paudrow/alarm-clock-m5cores3/hardware/cad/viewer_template.html

# Alarm clock enclosure.

From the V2 breadboard, with 3D-printed holders, to the V3 black-anodized aluminium clock on a ½″ low-iron glass base that glows 660 nm red. Drag to orbit, scroll or pinch to zoom, hover a part to name it, and press Explode to take it apart.

Loading model…

¾ view Front Back Side Below

Interact Explode

Tap, hold and drag on the clock's screen. It's running the real firmware. Press Done or Esc to leave.

## Version

V2 breadboard V3 · 4.1″ V3 · 2.41″

Explode

Lamp on See inside Screen on Colour parts

## The clock, running

Time

–

Screen

–

Alarm

–

Lamp

–

Sleep sound

–

Resolution

–

Jump to

Daytime Wind down Night Wake up Alarm

Clock speed

Real time 60× 600×

Set the clock to Set

Press the button Sleep sound on/off

Serial Send

Hear it Reset its settings

This is the clock's real firmware, src/main.cpp, compiled to WebAssembly. It draws here and on the model's screen, drives the lamp in the glass and plays the sleep sounds. On the model, click the screen to use it, the glass to switch the lamp, the speaker for sleep sounds and the top button to snooze. Jump to moves the clock's time. Wind down and Wake up turn those lamp schedules on and jump to their start; Alarm turns the alarm on and sets the clock 10 seconds before it. The Serial box takes the same commands as the real clock's USB console; so does clock.command() in the browser console. Settings are kept in this browser, the way the clock keeps them through a power cut.

## Fit check

## Cost per clock, batch of 10

Item | $ each

Your hours per clock

Your rate, $/h

Selling price

Cash

With your time

Margin each

Edit any price to try a real quote; your edits stay in this browser. Margin allows 3% for card fees and assumes shipping is charged to the buyer. Certification (FCC testing, $1,000–3,000 for the batch) is not included.

## Where to buy

Links open the store's product page. Prices are from search results and were not checked in a cart; confirm before ordering.

## Parts

Generated from hardware/cad/clock.py (CadQuery). STEP and STL files for every part are in hardware/cad/out/, ready for the 3D printer or CAM. The 4.1″ screen module uses the outline measured from LilyGO's published T-Display-P4 model; the 2.41″ outline is an estimate until the Waveshare drawing is checked. The screen, lamp and speaker are driven by the clock's real firmware (src/main.cpp), running in the page.
