paudrow/alarm-clock-m5cores3/hardware/cad/out/bench/assembly.step

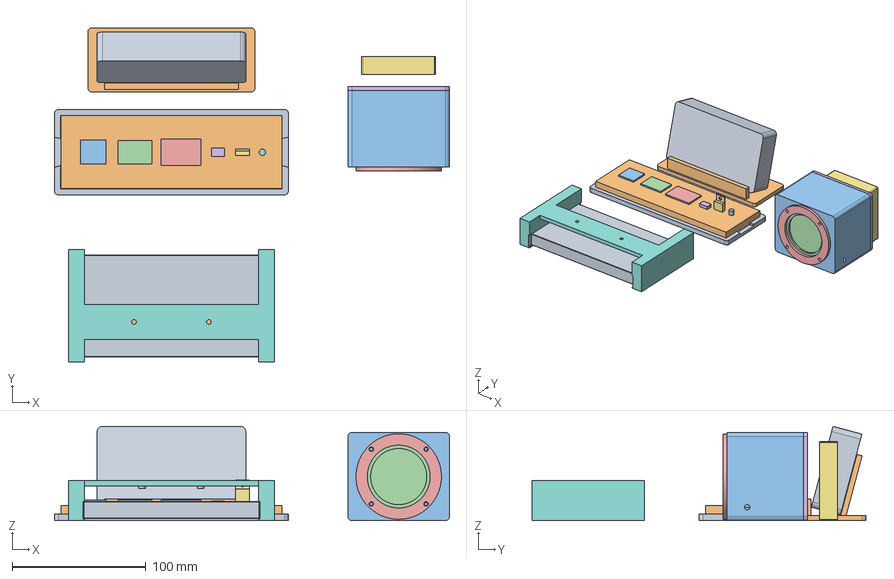
[picture p2: CAD file, 2026-09-29]
hardware/cad/out/bench/assembly.step
295.5 x 250.1 x 70.6 mm
bb_tray
breadboard
amp
light_sensor
rtc
opamp
mosfet
mosfet_small
tdisplay
display_stand
spk_box
speaker
spk_ring
spk_lid
spk_filler
lamp_cradle
glass_sample
led_stars
