paudrow/alarm-clock-m5cores3/hardware/cad/out/lean/assembly.step

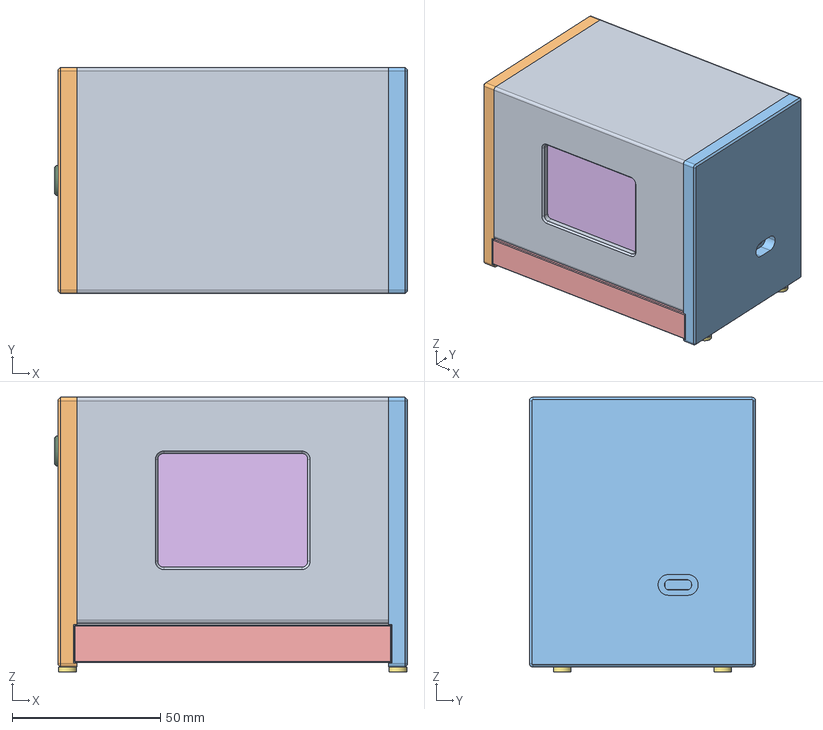
[picture p3: CAD file, 2026-09-29]
hardware/cad/out/lean/assembly.step
118.9 x 76.2 x 92.5 mm
tube
cap_left
cap_right
button
glass_base
screen
screen_frame
sled
pcb
standoffs
usb_c
leds
chamber
speaker
feet
