paudrow/alarm-clock-m5cores3/hardware/cad/out/bench/display_stand.step

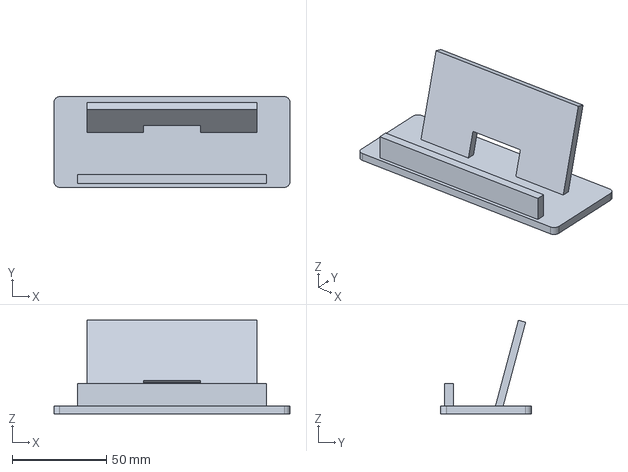
[picture p4: CAD file, 2026-09-29]
hardware/cad/out/bench/display_stand.step
125.0 x 48.0 x 49.5 mm
