paudrow/alarm-clock-m5cores3/hardware/cad/out/lean/screen.step

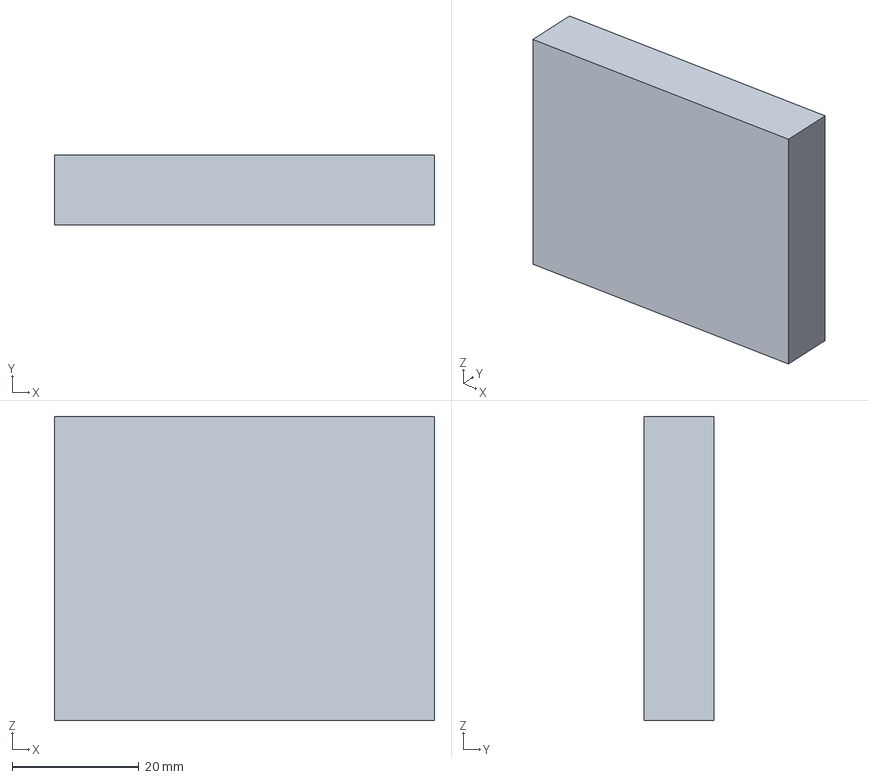
[picture p5: CAD file, 2026-09-29]
hardware/cad/out/lean/screen.step
60.0 x 11.0 x 48.0 mm
