paudrow/alarm-clock-m5cores3/hardware/cad/out/full/screen_frame.step

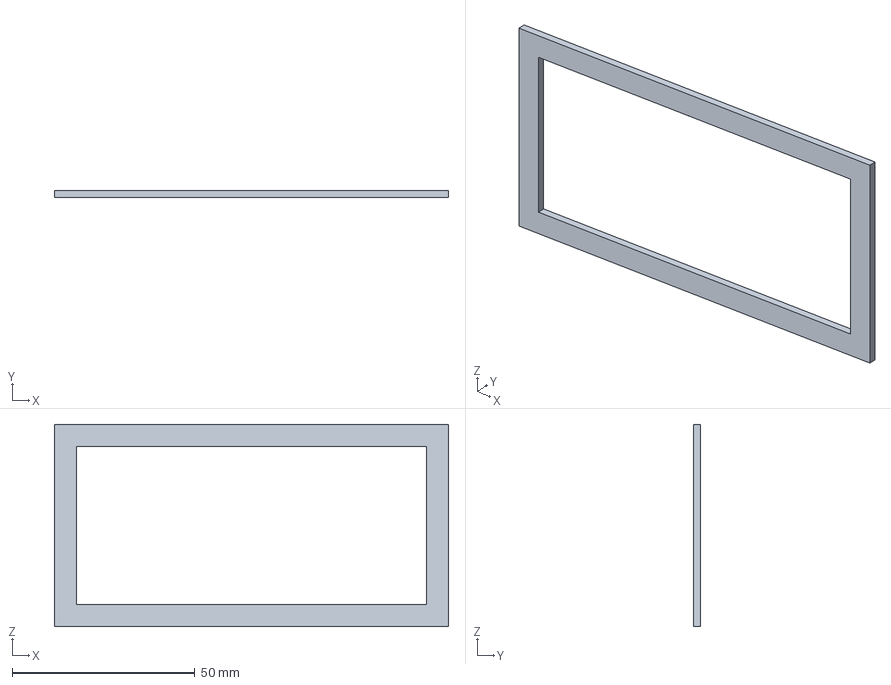
[picture p6: CAD file, 2026-09-29]
hardware/cad/out/full/screen_frame.step
107.8 x 2.00 x 55.3 mm
