paudrow/alarm-clock-m5cores3/hardware/cad/out/lean/feet.step

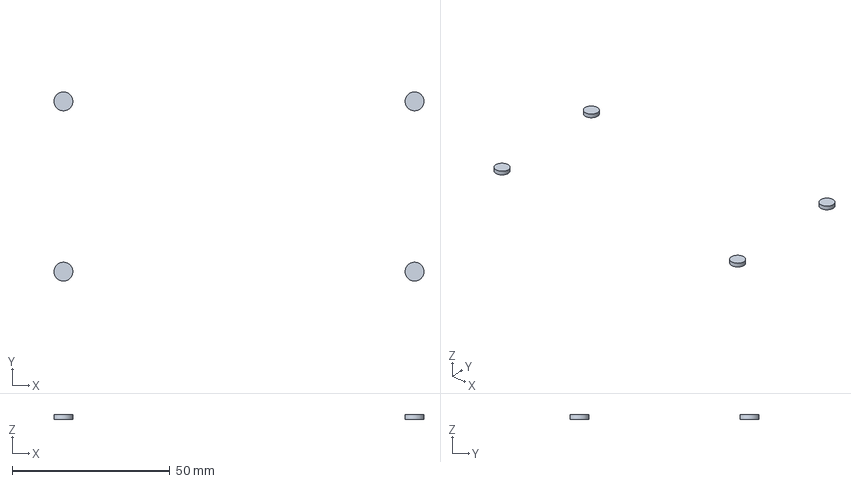
[picture p7: CAD file, 2026-09-29]
hardware/cad/out/lean/feet.step
117.3 x 60.0 x 1.60 mm
