paudrow/alarm-clock-m5cores3/hardware/cad/out/bench/bb_tray.step

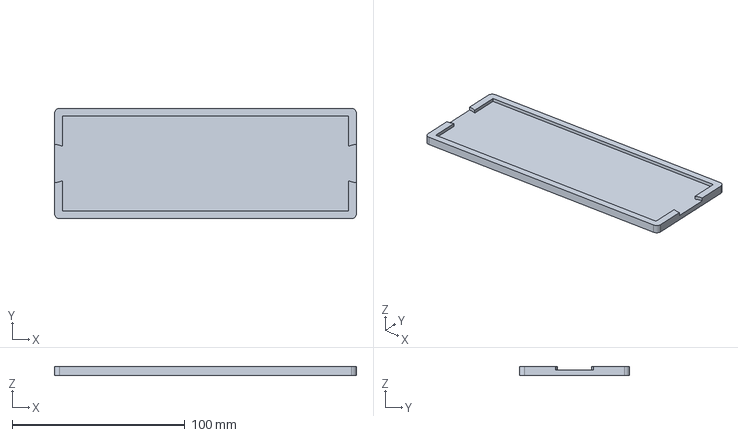
[picture p8: CAD file, 2026-09-29]
hardware/cad/out/bench/bb_tray.step
175.0 x 64.0 x 5.00 mm
