paudrow/alarm-clock-m5cores3/hardware/cad/out/full/screen.step

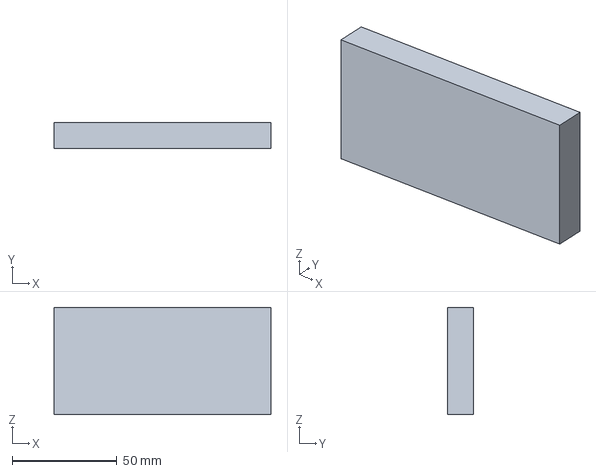
[picture p9: CAD file, 2026-09-29]
hardware/cad/out/full/screen.step
103.8 x 12.3 x 51.3 mm
