paudrow/alarm-clock-m5cores3/hardware/cad/out/lean/standoffs.step

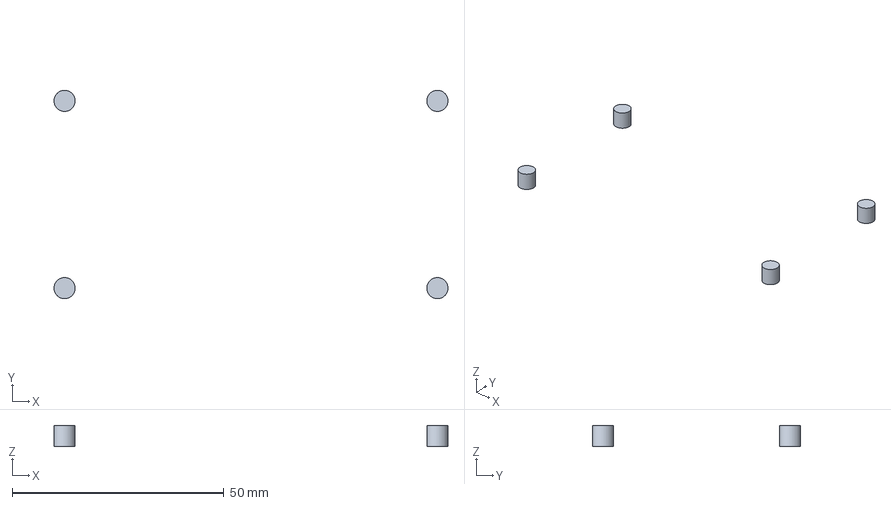
[picture p10: CAD file, 2026-09-29]
hardware/cad/out/lean/standoffs.step
93.0 x 49.2 x 5.00 mm
