paudrow/alarm-clock-m5cores3/hardware/cad/out/bench/glass_sample.step

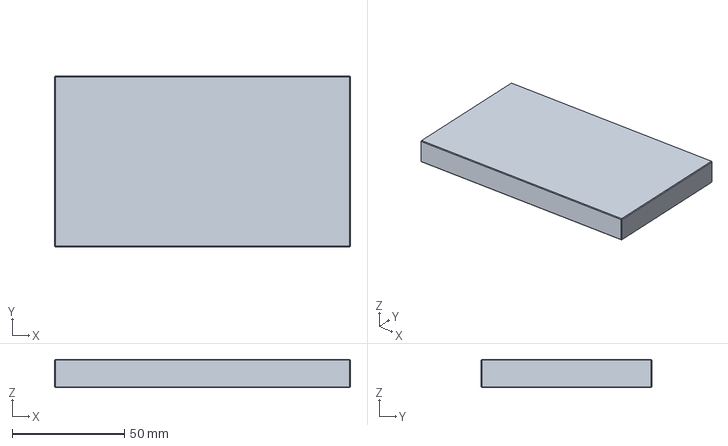
[picture p11: CAD file, 2026-09-29]
hardware/cad/out/bench/glass_sample.step
132.0 x 76.2 x 12.7 mm
