paudrow/alarm-clock-m5cores3/hardware/cad/out/full/tube.step

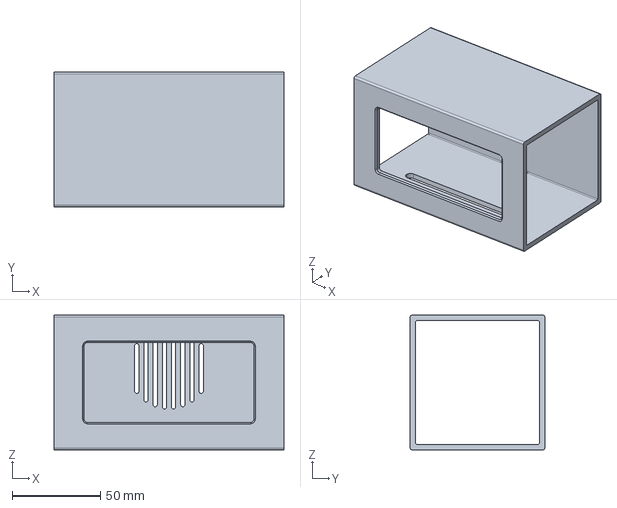
[picture p12: CAD file, 2026-09-29]
hardware/cad/out/full/tube.step
130.0 x 76.2 x 76.2 mm
