paudrow/alarm-clock-m5cores3/hardware/cad/out/bench/amp.step

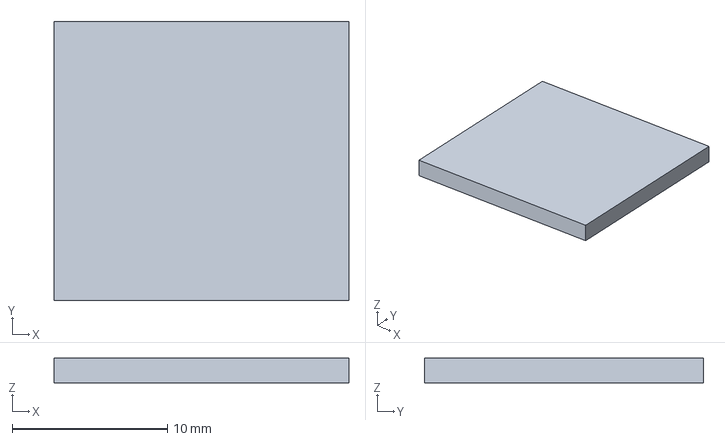
[picture p14: CAD file, 2026-09-29]
hardware/cad/out/bench/amp.step
19.0 x 18.0 x 1.60 mm
