paudrow/alarm-clock-m5cores3/hardware/cad/out/full/speaker.step

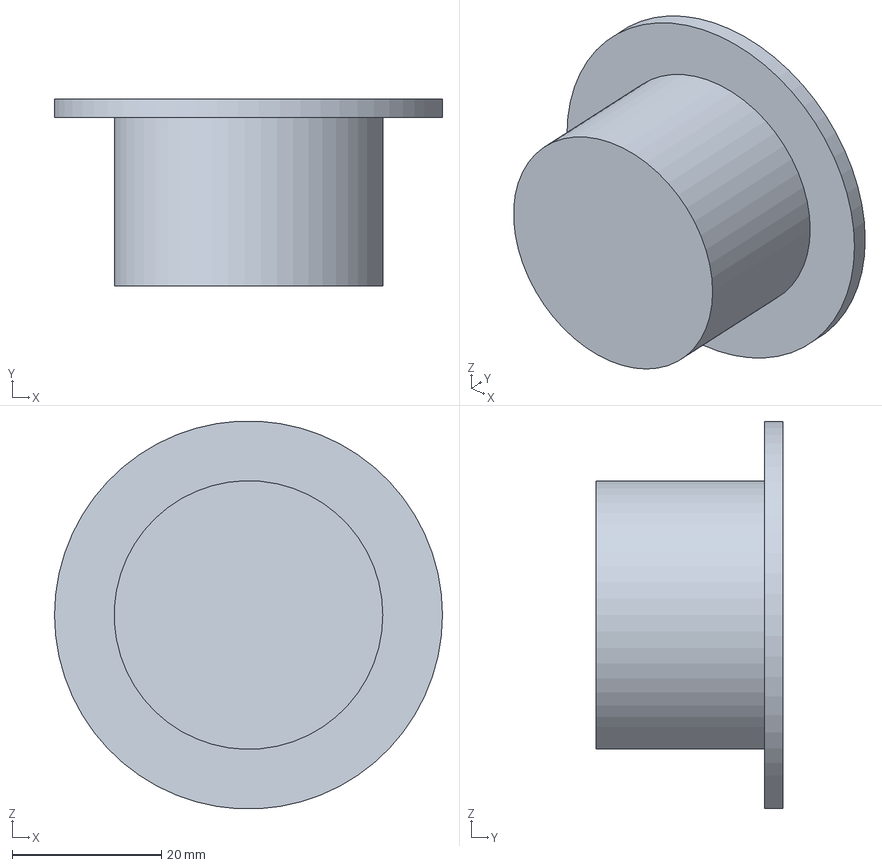
[picture p15: CAD file, 2026-09-29]
hardware/cad/out/full/speaker.step
52.0 x 25.1 x 51.9 mm
