paudrow/alarm-clock-m5cores3/hardware/cad/out/lean/sled.step

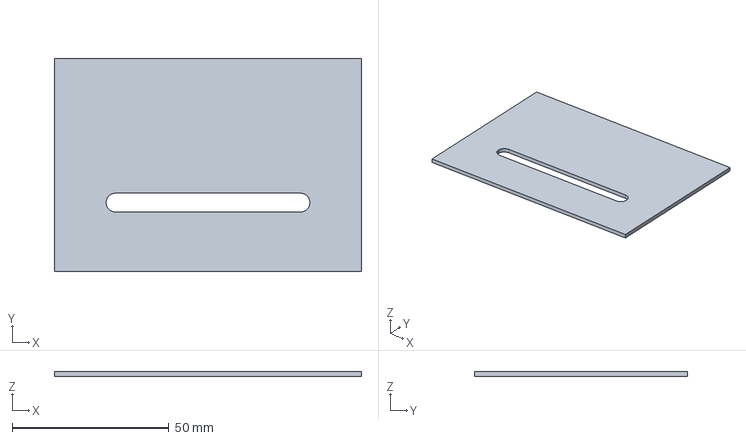
[picture p16: CAD file, 2026-09-29]
hardware/cad/out/lean/sled.step
98.0 x 67.8 x 1.60 mm
