paudrow/alarm-clock-m5cores3/hardware/cad/out/bench/mosfet.step

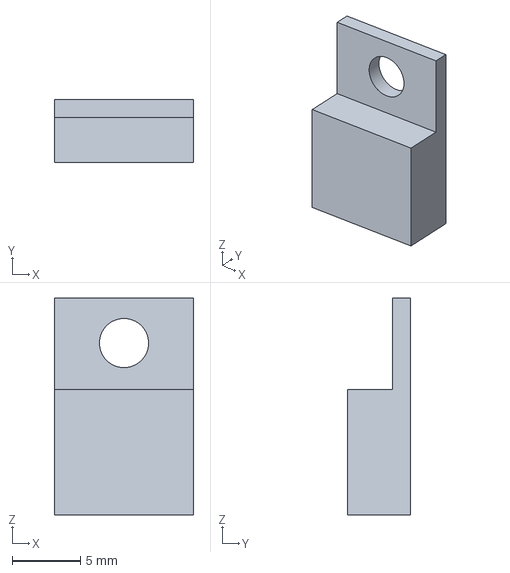
[picture p17: CAD file, 2026-09-29]
hardware/cad/out/bench/mosfet.step
10.2 x 4.60 x 15.9 mm
