paudrow/alarm-clock-m5cores3/hardware/cad/out/full/chamber.step

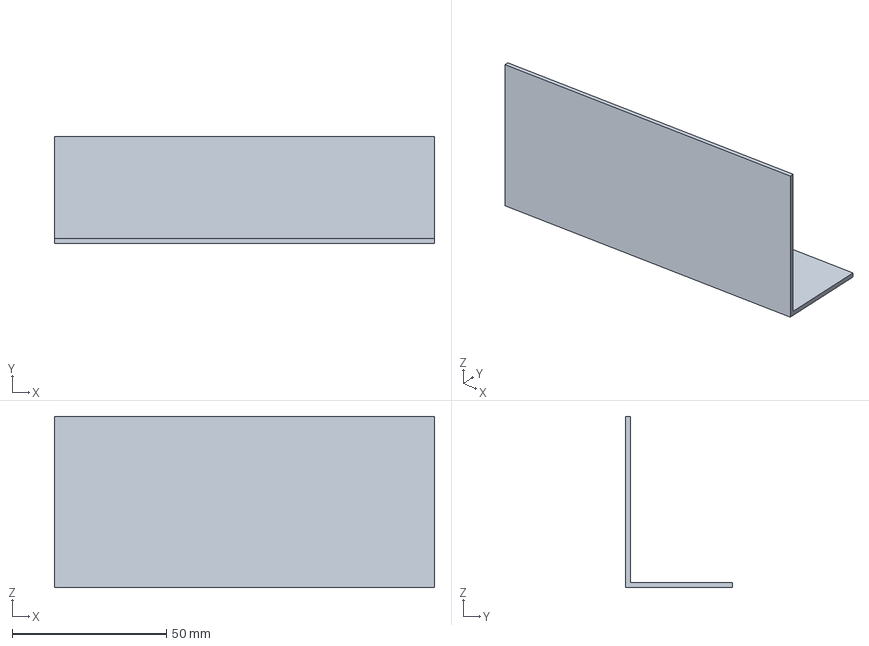
[picture p18: CAD file, 2026-09-29]
hardware/cad/out/full/chamber.step
123.0 x 34.6 x 55.3 mm
