paudrow/alarm-clock-m5cores3/hardware/cad/out/lean/glass_base.step

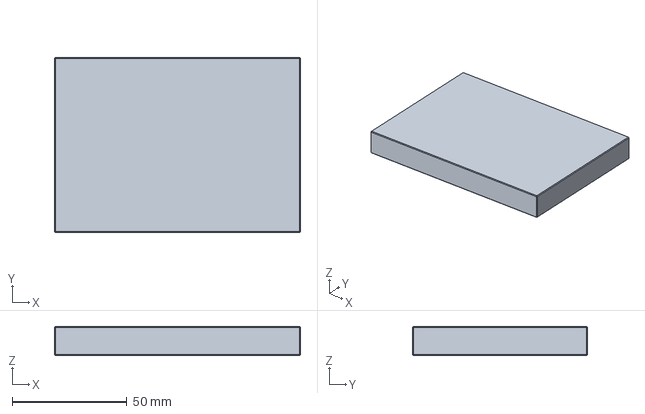
[picture p19: CAD file, 2026-09-29]
hardware/cad/out/lean/glass_base.step
107.0 x 76.2 x 12.7 mm
