paudrow/alarm-clock-m5cores3/hardware/cad/out/bench/speaker.step

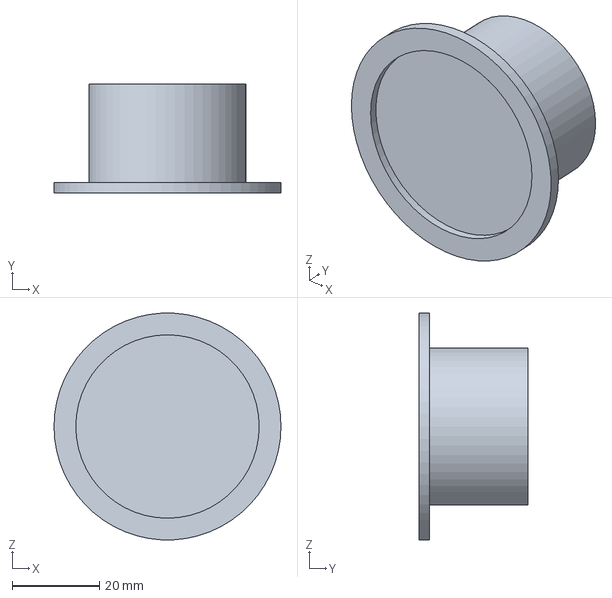
[picture p20: CAD file, 2026-09-29]
hardware/cad/out/bench/speaker.step
52.0 x 25.0 x 51.9 mm
