paudrow/alarm-clock-m5cores3/hardware/cad/out/full/pcb.step

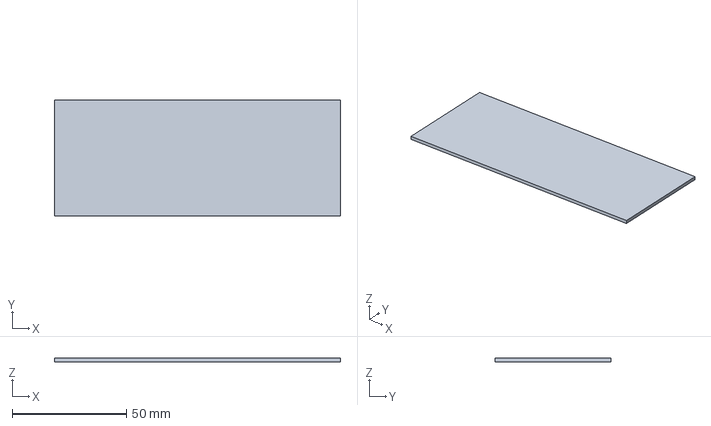
[picture p21: CAD file, 2026-09-29]
hardware/cad/out/full/pcb.step
125.0 x 50.9 x 1.60 mm
