paudrow/alarm-clock-m5cores3/hardware/cad/out/bench/mosfet_small.step

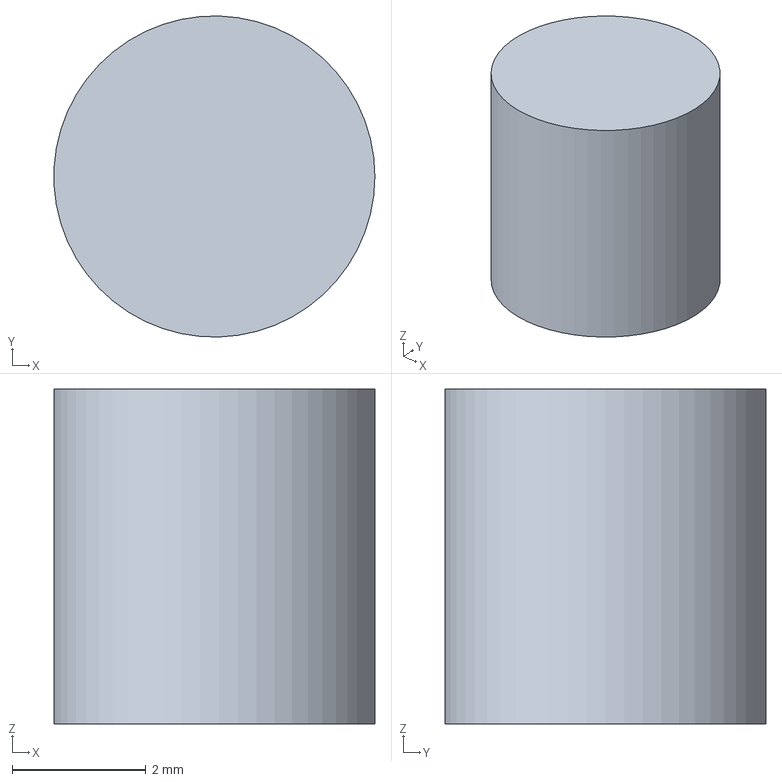
[picture p22: CAD file, 2026-09-29]
hardware/cad/out/bench/mosfet_small.step
4.80 x 4.80 x 5.00 mm
