paudrow/alarm-clock-m5cores3/hardware/cad/out/full/sled.step

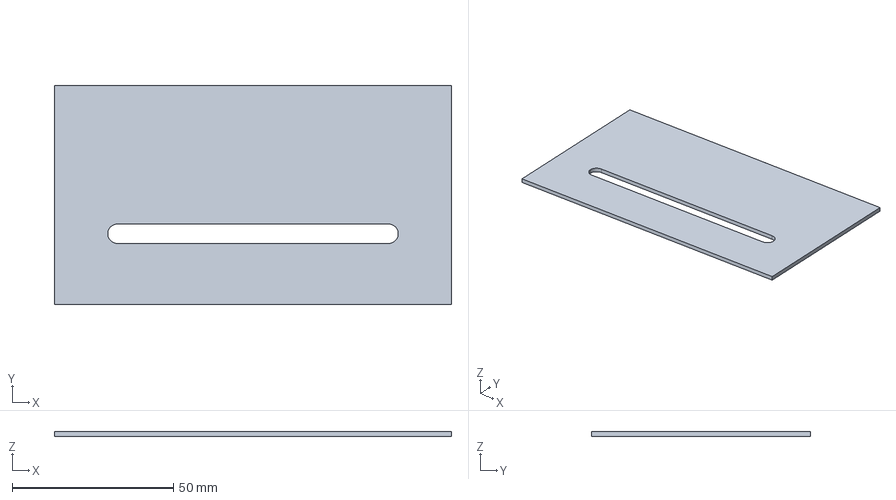
[picture p23: CAD file, 2026-09-29]
hardware/cad/out/full/sled.step
123.0 x 67.8 x 1.60 mm
