paudrow/alarm-clock-m5cores3/hardware/cad/out/lean/button.step

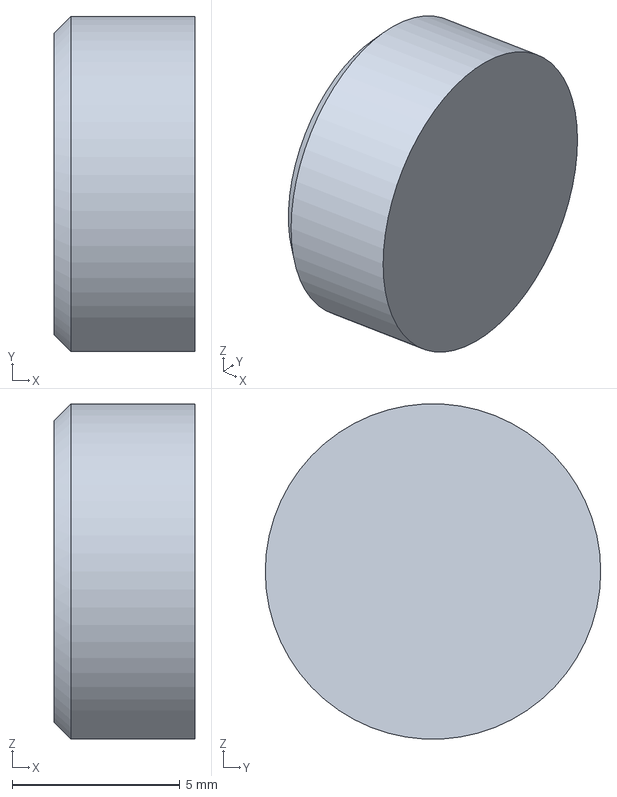
[picture p24: CAD file, 2026-09-29]
hardware/cad/out/lean/button.step
4.20 x 10.0 x 9.99 mm
