paudrow/alarm-clock-m5cores3/hardware/cad/out/bench/breadboard.step

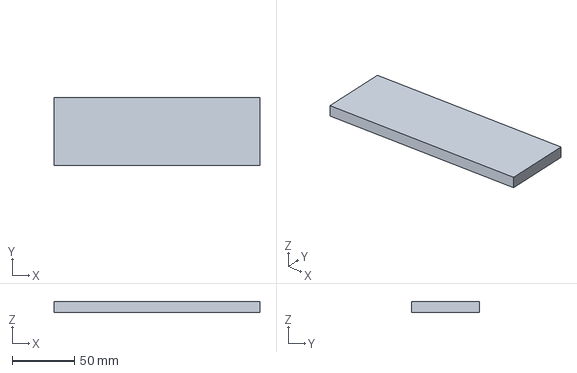
[picture p25: CAD file, 2026-09-29]
hardware/cad/out/bench/breadboard.step
165.1 x 54.6 x 8.50 mm
