paudrow/alarm-clock-m5cores3/hardware/cad/out/full/cap_right.step

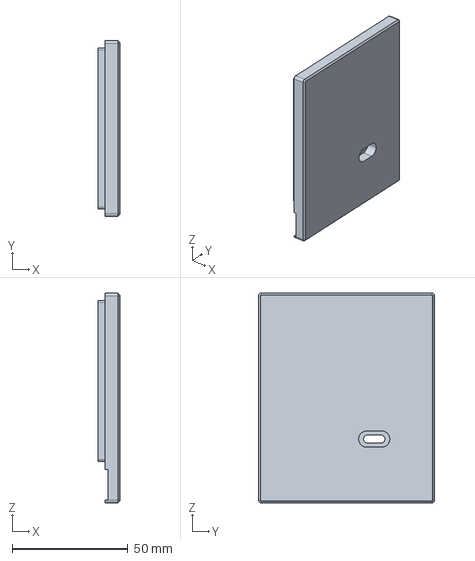
[picture p26: CAD file, 2026-09-29]
hardware/cad/out/full/cap_right.step
9.35 x 76.2 x 90.9 mm
