paudrow/alarm-clock-m5cores3/hardware/cad/out/lean/tube.step

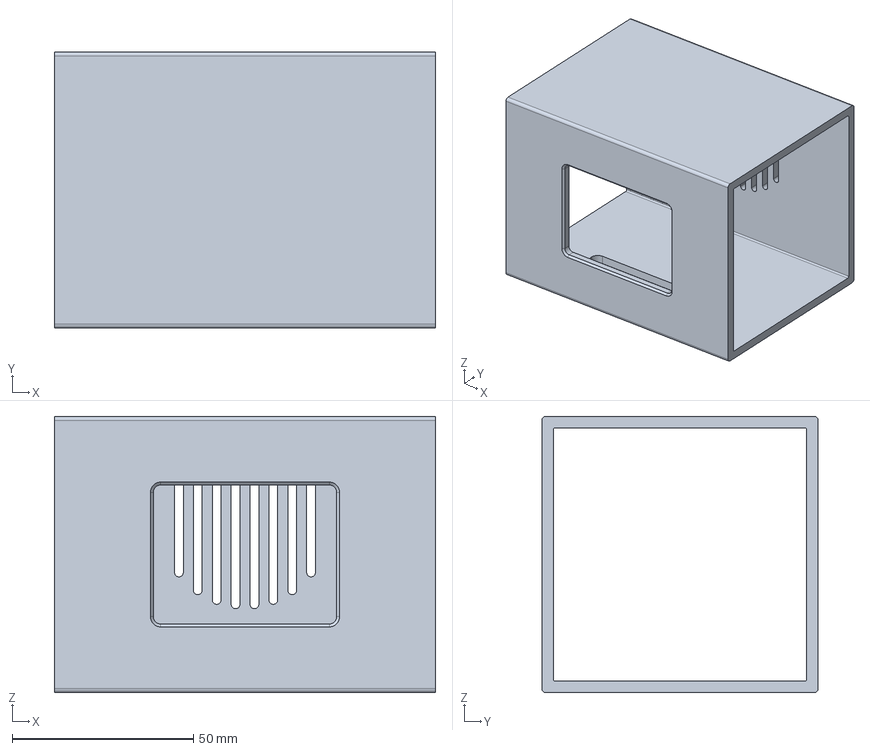
[picture p27: CAD file, 2026-09-29]
hardware/cad/out/lean/tube.step
105.0 x 76.2 x 76.2 mm
