paudrow/alarm-clock-m5cores3/hardware/cad/out/bench/lamp_cradle.step

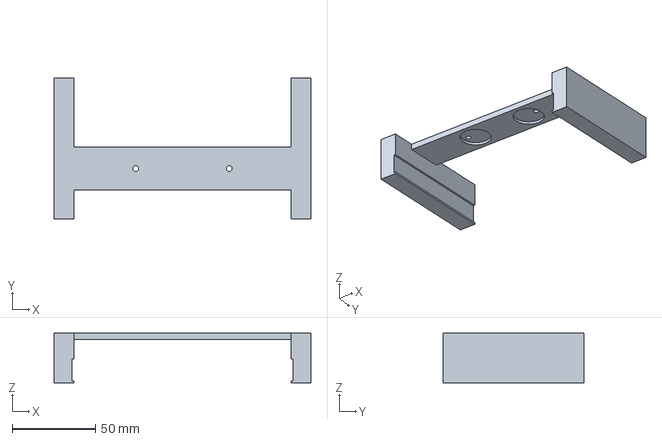
[picture p28: CAD file, 2026-09-29]
hardware/cad/out/bench/lamp_cradle.step
154.0 x 84.2 x 29.9 mm
