paudrow/alarm-clock-m5cores3/hardware/cad/out/full/standoffs.step

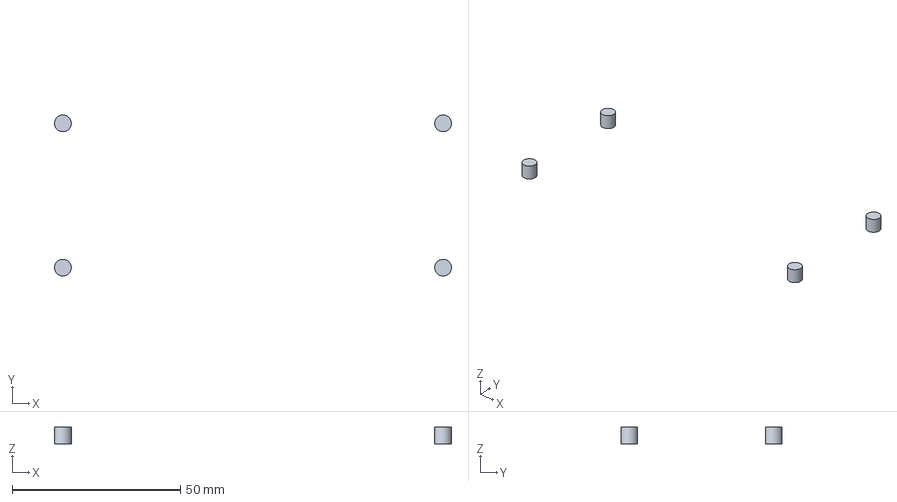
[picture p29: CAD file, 2026-09-29]
hardware/cad/out/full/standoffs.step
118.0 x 47.9 x 5.00 mm
