paudrow/alarm-clock-m5cores3/hardware/cad/out/lean/pcb.step

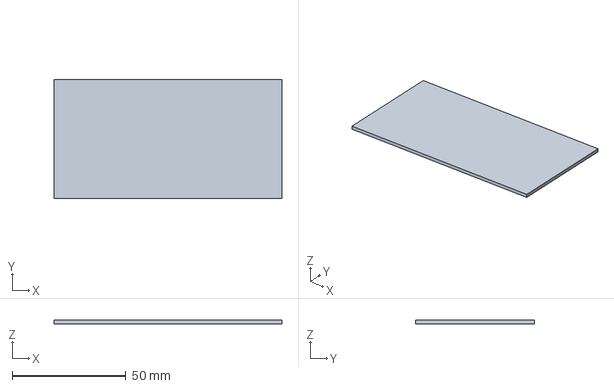
[picture p30: CAD file, 2026-09-29]
hardware/cad/out/lean/pcb.step
100.0 x 52.2 x 1.60 mm
