paudrow/alarm-clock-m5cores3/hardware/cad/out/bench/light_sensor.step

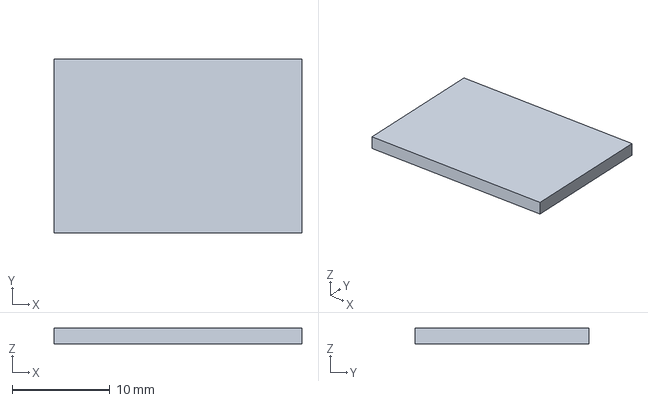
[picture p31: CAD file, 2026-09-29]
hardware/cad/out/bench/light_sensor.step
25.4 x 17.8 x 1.60 mm
