paudrow/alarm-clock-m5cores3/hardware/cad/out/lean/usb_c.step

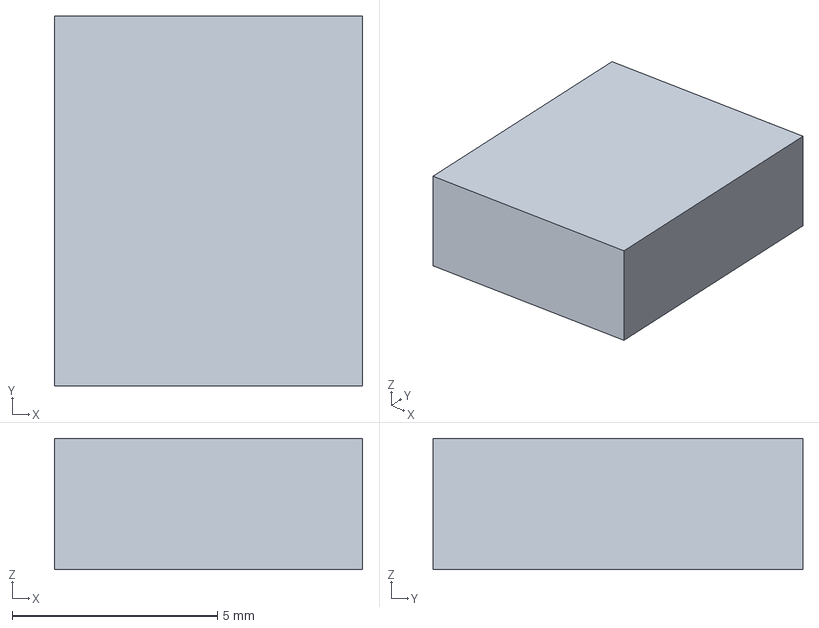
[picture p32: CAD file, 2026-09-29]
hardware/cad/out/lean/usb_c.step
7.50 x 9.00 x 3.20 mm
