paudrow/alarm-clock-m5cores3/hardware/cad/out/bench/rtc.step

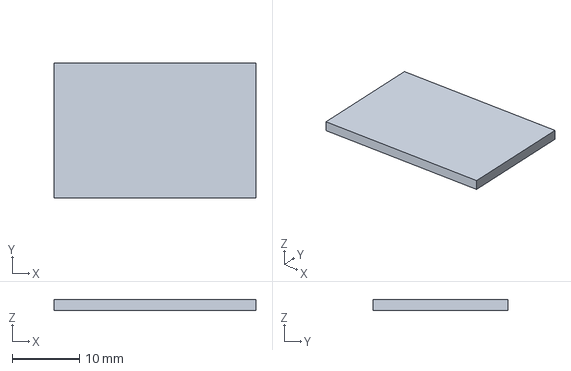
[picture p33: CAD file, 2026-09-29]
hardware/cad/out/bench/rtc.step
30.0 x 20.0 x 1.60 mm
