paudrow/alarm-clock-m5cores3/hardware/cad/out/lean/chamber.step

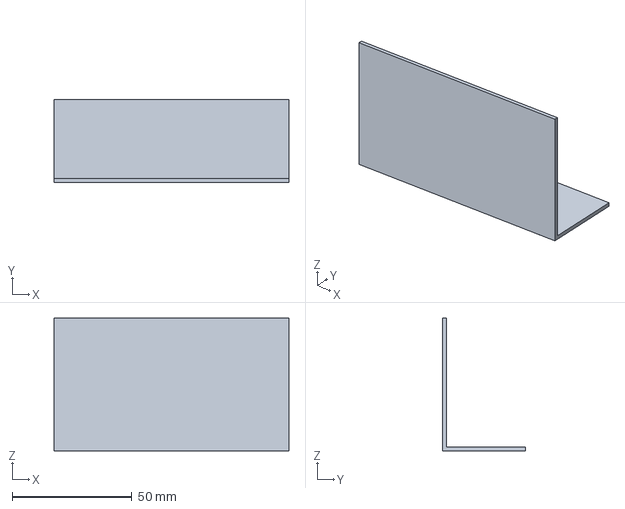
[picture p34: CAD file, 2026-09-29]
hardware/cad/out/lean/chamber.step
98.0 x 34.6 x 55.3 mm
