paudrow/alarm-clock-m5cores3/hardware/cad/out/bench/led_stars.step

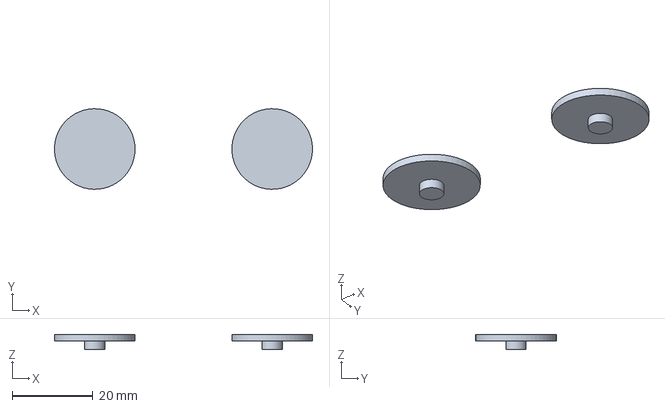
[picture p35: CAD file, 2026-09-29]
hardware/cad/out/bench/led_stars.step
64.0 x 20.0 x 3.60 mm
