paudrow/alarm-clock-m5cores3/hardware/cad/out/lean/leds.step

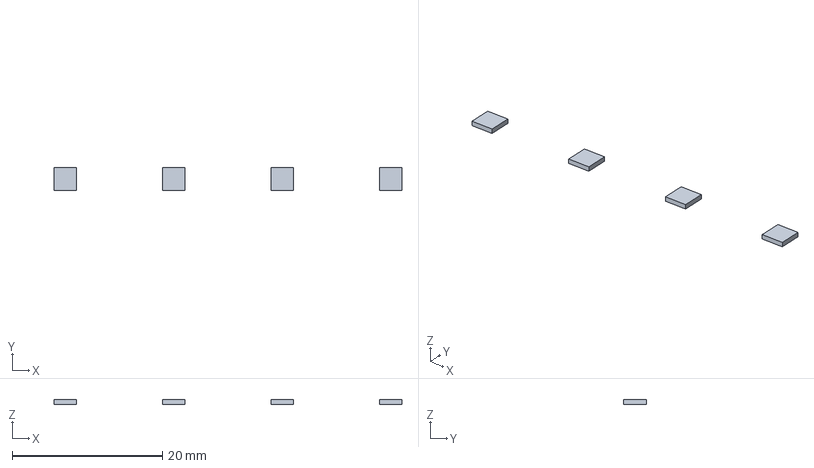
[picture p36: CAD file, 2026-09-29]
hardware/cad/out/lean/leds.step
46.3 x 3.00 x 0.6 mm
