paudrow/alarm-clock-m5cores3/hardware/cad/out/bench/spk_ring.step

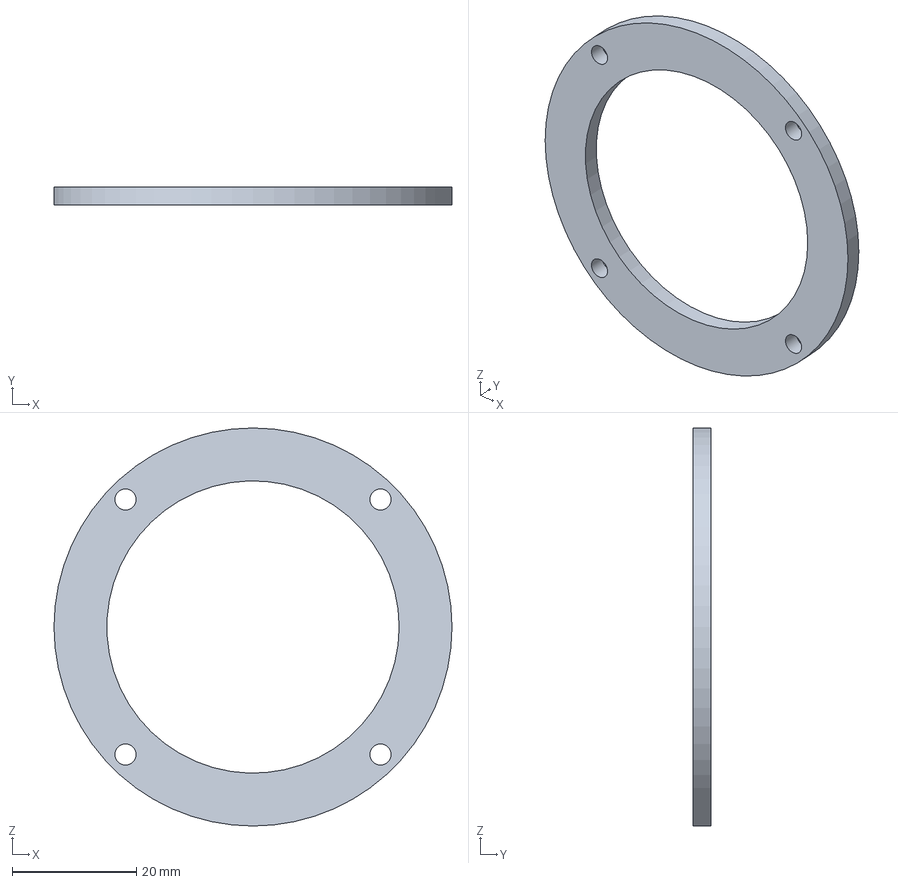
[picture p37: CAD file, 2026-09-29]
hardware/cad/out/bench/spk_ring.step
64.0 x 2.95 x 64.0 mm
