paudrow/alarm-clock-m5cores3/hardware/cad/out/bench/spk_box.step

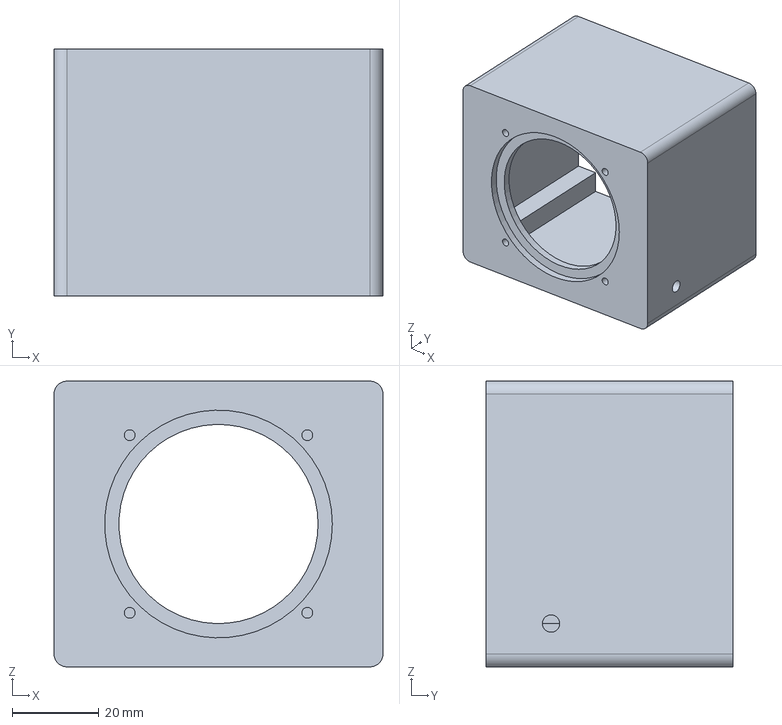
[picture p38: CAD file, 2026-09-29]
hardware/cad/out/bench/spk_box.step
76.0 x 57.0 x 66.0 mm
