paudrow/alarm-clock-m5cores3/hardware/cad/out/full/leds.step

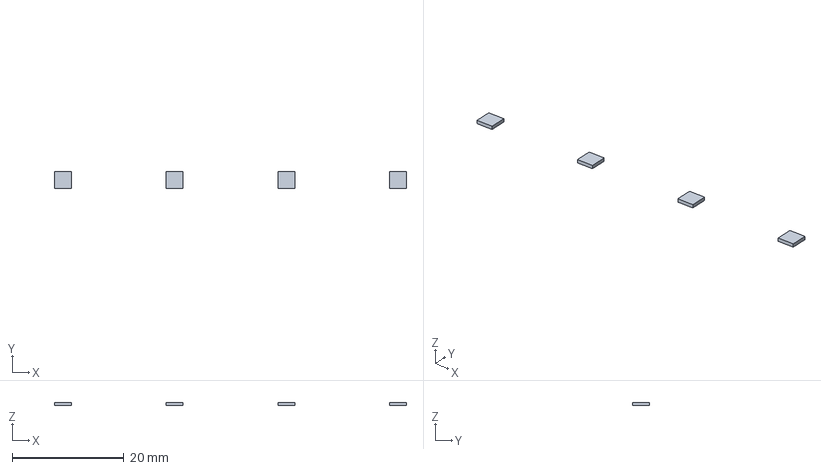
[picture p39: CAD file, 2026-09-29]
hardware/cad/out/full/leds.step
63.0 x 3.00 x 0.6 mm
