paudrow/alarm-clock-m5cores3/hardware/cad/out/bench/spk_lid.step

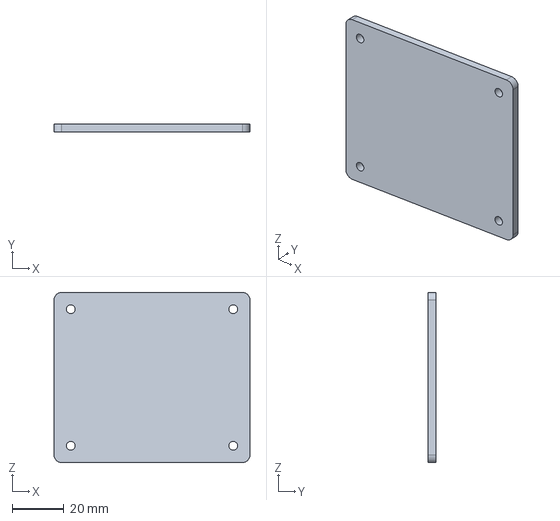
[picture p40: CAD file, 2026-09-29]
hardware/cad/out/bench/spk_lid.step
76.0 x 3.00 x 66.0 mm
