paudrow/alarm-clock-m5cores3/hardware/cad/out/full/feet.step

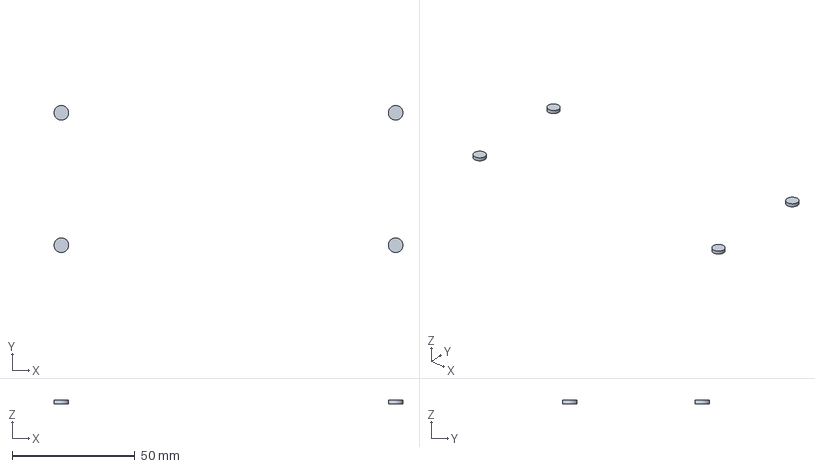
[picture p41: CAD file, 2026-09-29]
hardware/cad/out/full/feet.step
142.3 x 60.0 x 1.60 mm
