paudrow/alarm-clock-m5cores3/hardware/cad/out/lean/screen_frame.step

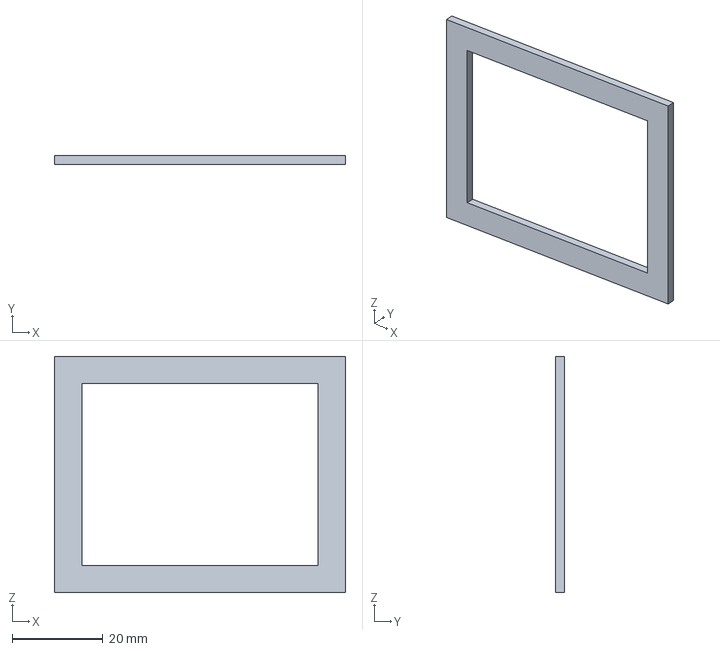
[picture p42: CAD file, 2026-09-29]
hardware/cad/out/lean/screen_frame.step
64.0 x 2.00 x 52.0 mm
