paudrow/alarm-clock-m5cores3/hardware/cad/out/bench/tdisplay.step

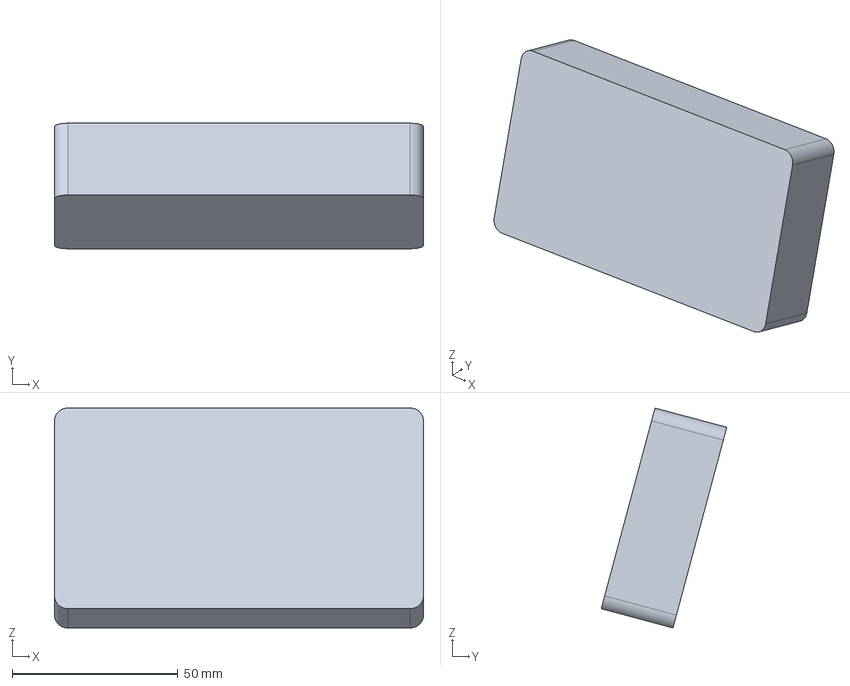
[picture p43: CAD file, 2026-09-29]
hardware/cad/out/bench/tdisplay.step
111.2 x 37.8 x 66.3 mm
