paudrow/alarm-clock-m5cores3/hardware/cad/out/bench/opamp.step

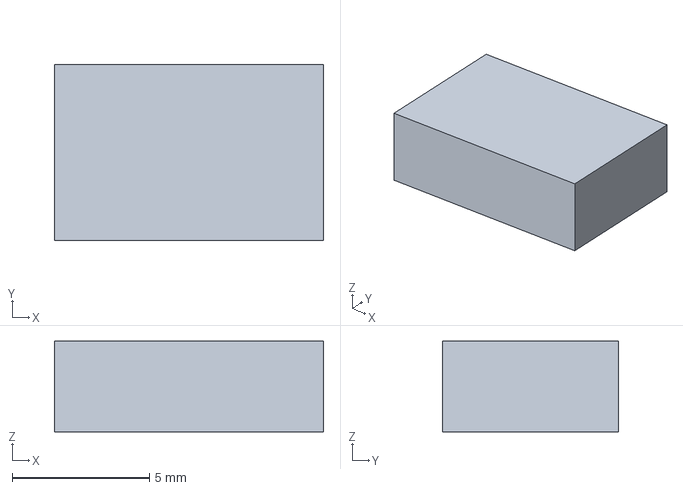
[picture p44: CAD file, 2026-09-29]
hardware/cad/out/bench/opamp.step
9.80 x 6.40 x 3.30 mm
