paudrow/alarm-clock-m5cores3/hardware/cad/out/bench/spk_filler.step

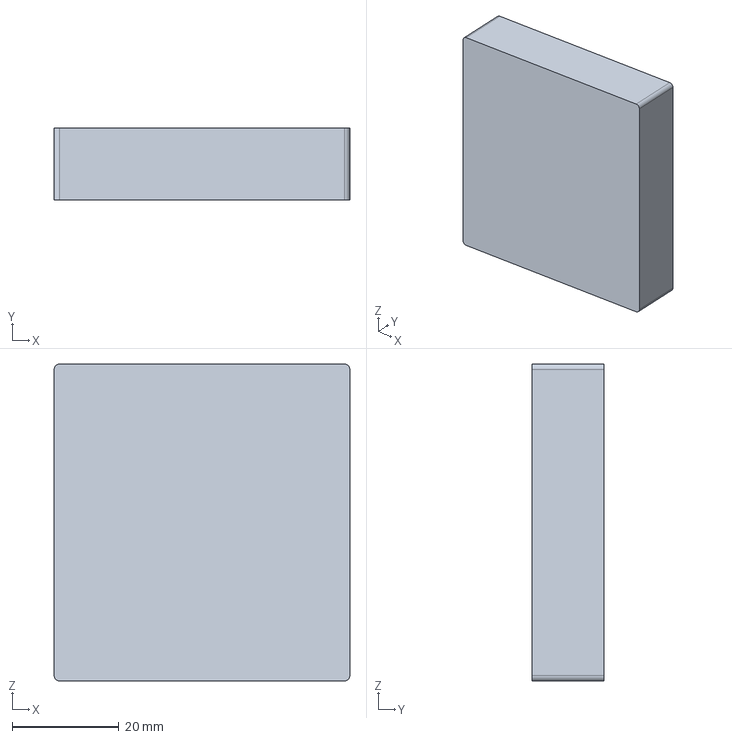
[picture p45: CAD file, 2026-09-29]
hardware/cad/out/bench/spk_filler.step
55.4 x 13.5 x 59.4 mm
