paudrow/alarm-clock-m5cores3/(list of files, cad)

Other CAD files:
hardware/cad/out/lean/cap_left.step
hardware/cad/out/full/cap_left.step
hardware/cad/out/full/button.step
hardware/cad/out/full/glass_base.step
hardware/cad/out/full/usb_c.step
hardware/cad/out/lean/speaker.step
hardware/cad/out/bench/amp.stl
hardware/cad/out/bench/bb_tray.stl
hardware/cad/out/bench/breadboard.stl
hardware/cad/out/bench/display_stand.stl
hardware/cad/out/bench/glass_sample.stl
hardware/cad/out/bench/lamp_cradle.stl
hardware/cad/out/bench/led_stars.stl
hardware/cad/out/bench/light_sensor.stl
hardware/cad/out/bench/mosfet.stl
hardware/cad/out/bench/mosfet_small.stl
hardware/cad/out/bench/opamp.stl
hardware/cad/out/bench/rtc.stl
hardware/cad/out/bench/speaker.stl
hardware/cad/out/bench/spk_box.stl
hardware/cad/out/bench/spk_filler.stl
hardware/cad/out/bench/spk_lid.stl
hardware/cad/out/bench/spk_ring.stl
hardware/cad/out/bench/tdisplay.stl
hardware/cad/out/full/button.stl
hardware/cad/out/full/cap_left.stl
hardware/cad/out/full/cap_right.stl
hardware/cad/out/full/chamber.stl
hardware/cad/out/full/feet.stl
hardware/cad/out/full/glass_base.stl
hardware/cad/out/full/leds.stl
hardware/cad/out/full/pcb.stl
hardware/cad/out/full/screen.stl
hardware/cad/out/full/screen_frame.stl
hardware/cad/out/full/sled.stl
hardware/cad/out/full/speaker.stl
hardware/cad/out/full/standoffs.stl
hardware/cad/out/full/tube.stl
hardware/cad/out/full/usb_c.stl
hardware/cad/out/lean/button.stl
hardware/cad/out/lean/cap_left.stl
hardware/cad/out/lean/cap_right.stl
hardware/cad/out/lean/chamber.stl
hardware/cad/out/lean/feet.stl
hardware/cad/out/lean/glass_base.stl
hardware/cad/out/lean/leds.stl
hardware/cad/out/lean/pcb.stl
hardware/cad/out/lean/screen.stl
hardware/cad/out/lean/screen_frame.stl
hardware/cad/out/lean/sled.stl
hardware/cad/out/lean/speaker.stl
hardware/cad/out/lean/standoffs.stl
hardware/cad/out/lean/tube.stl
hardware/cad/out/lean/usb_c.stl
