paudrow/alarm-clock-m5cores3/test/screens/320x240-alarm.png

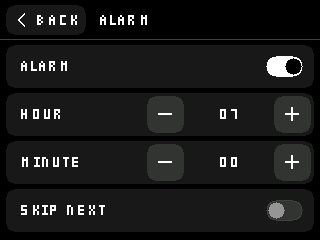
test/screens/320x240-alarm.png
