paudrow/alarm-clock-m5cores3/test/screens/320x240-alarm_sound.png

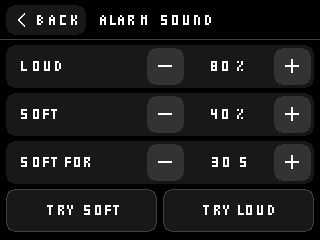
test/screens/320x240-alarm_sound.png
