paudrow/alarm-clock-m5cores3/test/screens/320x240-clock-day.png

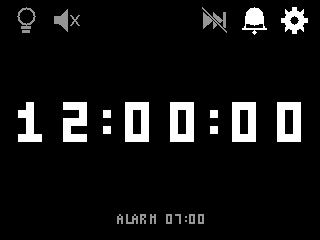
test/screens/320x240-clock-day.png
