paudrow/alarm-clock-m5cores3/test/screens/320x240-clock-night.png

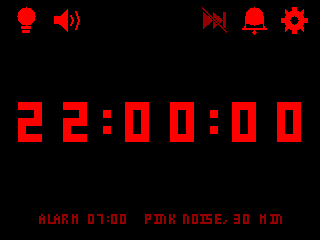
test/screens/320x240-clock-night.png
