paudrow/alarm-clock-m5cores3/test/screens/320x240-day_screen.png

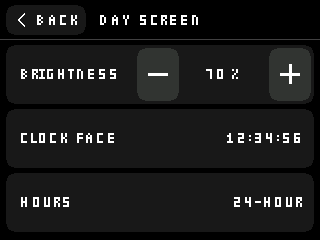
test/screens/320x240-day_screen.png
