paudrow/alarm-clock-m5cores3/test/screens/320x240-night_hours.png

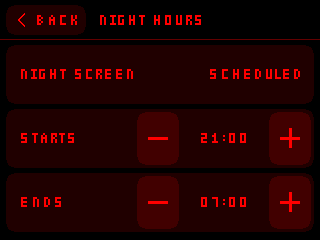
test/screens/320x240-night_hours.png
