paudrow/alarm-clock-m5cores3/test/screens/320x240-night_screen.png

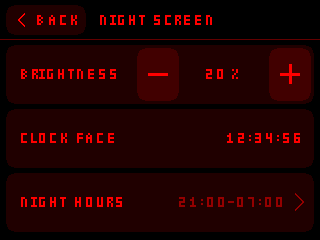
test/screens/320x240-night_screen.png
