paudrow/alarm-clock-m5cores3/test/screens/320x240-sleep_sounds.png

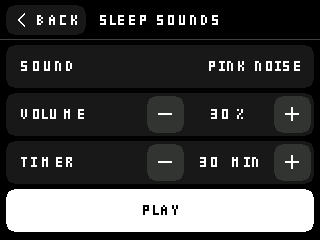
test/screens/320x240-sleep_sounds.png
