paudrow/alarm-clock-m5cores3/test/screens/320x240-wake_up.png

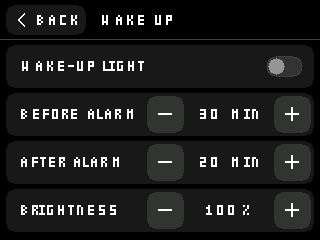
test/screens/320x240-wake_up.png
