paudrow/alarm-clock-m5cores3/test/screens/600x450-clock-ringing.png

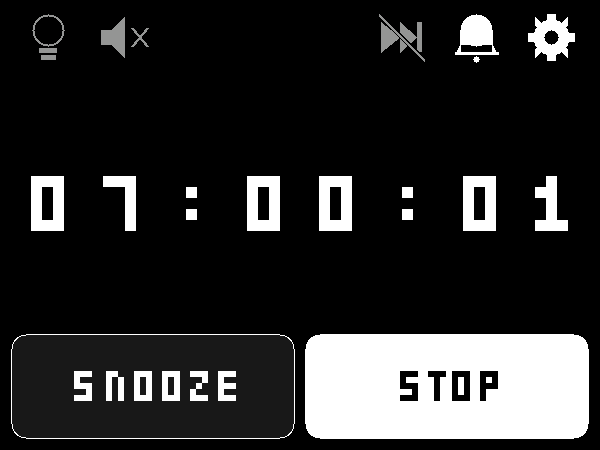
test/screens/600x450-clock-ringing.png
