paudrow/alarm-clock-m5cores3/test/screens/600x450-day_screen.png

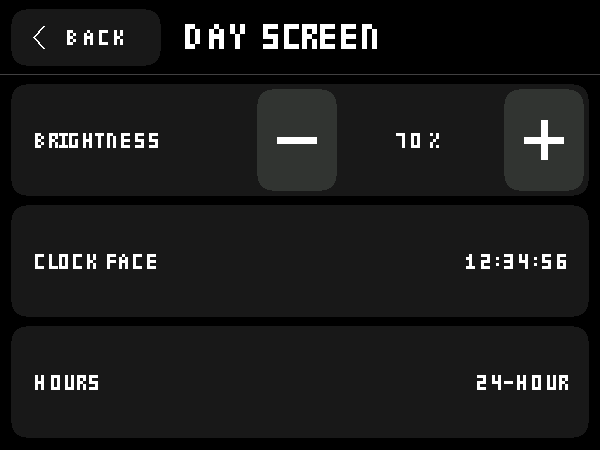
test/screens/600x450-day_screen.png
