paudrow/alarm-clock-m5cores3/test/screens/600x450-night_hours.png

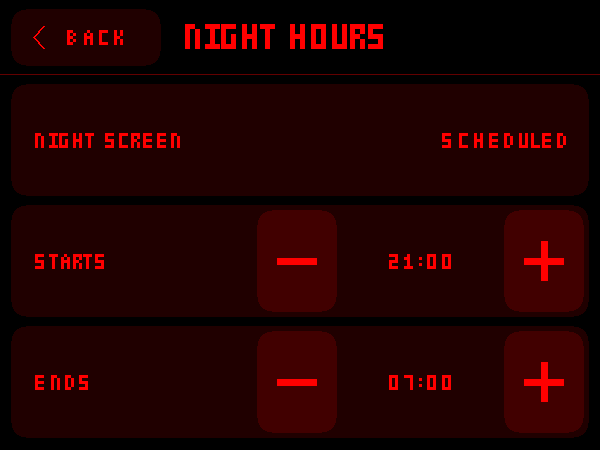
test/screens/600x450-night_hours.png
