paudrow/alarm-clock-m5cores3/test/screens/600x450-wind_down.png

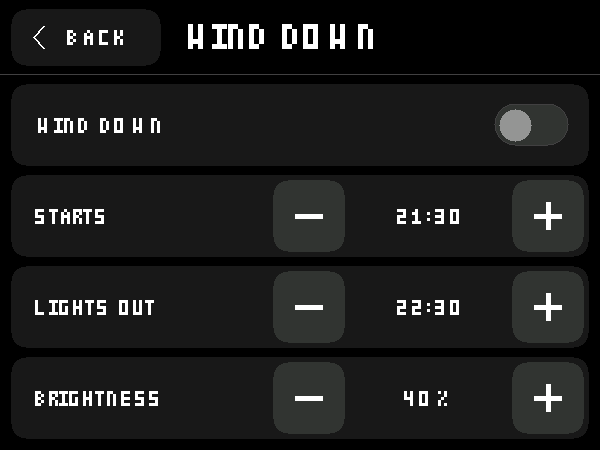
test/screens/600x450-wind_down.png
