paudrow/alarm-clock-m5cores3/test/screens/616x284-alarm.png

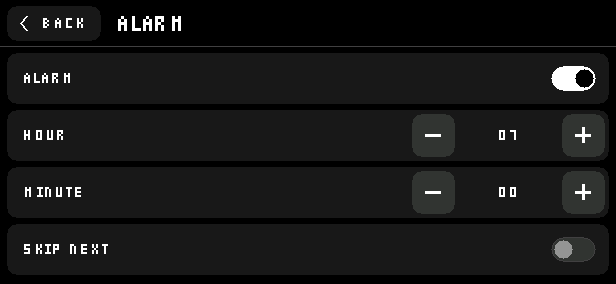
test/screens/616x284-alarm.png
