paudrow/alarm-clock-m5cores3/test/screens/616x284-alarm_sound.png

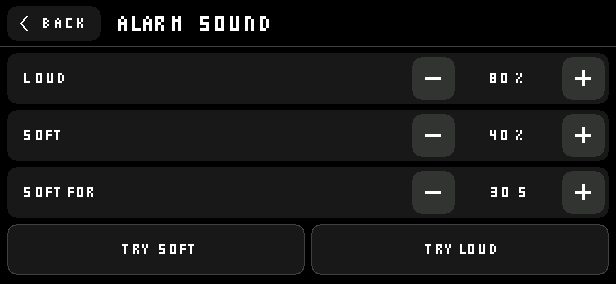
test/screens/616x284-alarm_sound.png
