paudrow/alarm-clock-m5cores3/test/screens/616x284-clock-ringing.png

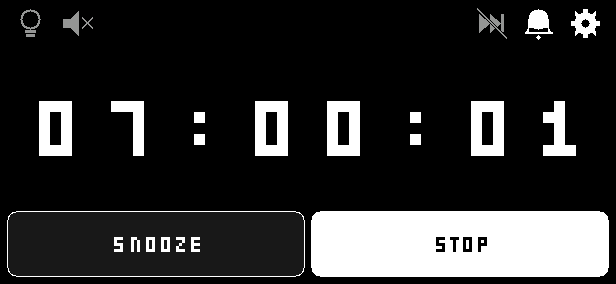
test/screens/616x284-clock-ringing.png
