paudrow/alarm-clock-m5cores3/test/screens/616x284-night_hours.png

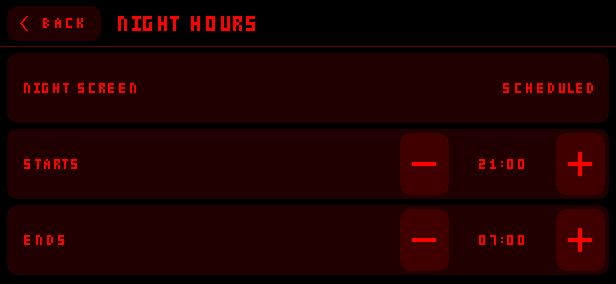
test/screens/616x284-night_hours.png
