paudrow/alarm-clock-m5cores3/test/screens/616x284-settings.png

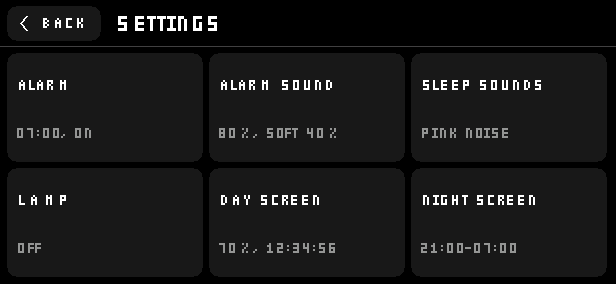
test/screens/616x284-settings.png
