paudrow/alarm-clock-m5cores3/test/screens/616x284-sleep_sounds.png

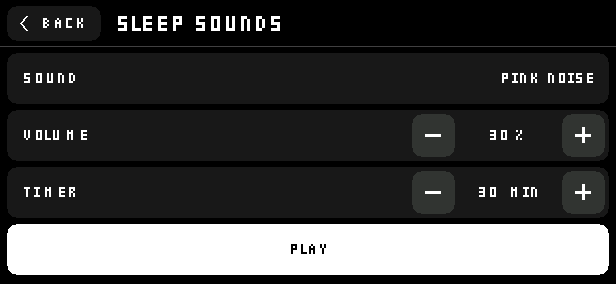
test/screens/616x284-sleep_sounds.png
