paudrow/alarm-clock-m5cores3/test/screens/616x284-wake_up.png

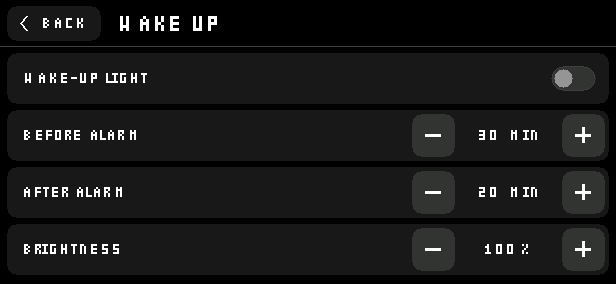
test/screens/616x284-wake_up.png
