paudrow/alarm-clock-m5cores3/(commit log)

2026-09-23 Add the CoreS3 bedside alarm, with settings that survive power loss and stop or snooze while it rings.
2026-09-29 Plan the custom hardware: design, parts, costs, certification and a 3D model (#1)
    Adds hardware/ with the design, bill of materials, first-batch plan, certification guide and manufacturing plan for taking the clock from the CoreS3 to a custom aluminium-and-glass build, plus a parametric CadQuery model (with collision checks, STEP/STL files and 3D-printable breadboard holders) and a three.js viewer deployable to alarmclock.audrow.com.
    Claude-Session: https://claude.ai/code/session_01CL9u8wcccZXQeAVwboNhNa
    [amp.step, amp.stl, assembly.step, bb_tray.step, bb_tray.stl, breadboard.step, breadboard.stl, button.step]
2026-09-30 Redesign the settings screens; add sleep sounds, a lamp and time travel to the simulator (#4)
    * Redesign the settings screens, add sleep sounds, a lamp and time travel to the simulator
    - Settings is a grid of tiles showing each setting's current value; pages
    share one row layout (steppers, switches, choices) with clearer names.
    - Every size comes from the screen's width and height, so the UI fits the
    CoreS3, the 4.1" and 2.41" AMOLEDs and anything from 160 x 128 up; text is
    measured and fitted so it never spills.
    - Sleep sounds: white, pink and brown noise generated live and streamed to
    the speaker, with fade-in, volume and a sleep timer; they stop for the alarm.
    - Lamp: on/off and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
    [M5Unified.h, alarm_face.hpp, alarm_face_test.cpp, firmware_test.cpp, main.cpp, render_screens.cpp]
2026-09-30 Schedule the lamp: wind down in the evening, wake up around the alarm (#5)
    The Lamp page gets two routines in place of the sunrise setting:
    - Wind down: on at a set brightness from a start time, fading out over the
    last 15 minutes to off at lights out. The clock face shows "Lights out"
    while it runs.
    - Wake up: brightens over a set number of minutes before the alarm to its
    own brightness, and stays on for a set number of minutes after. It follows
    the alarm, so moving, skipping or turning off the alarm moves, skips or
    stops the light.
    The lamp switch, icon and button still override: turning the lamp off puts
    a running routine out until it next starts. Serial commands winddown and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
    [alarm_face.hpp, alarm_face_test.cpp, firmware_test.cpp, main.cpp, render_screens.cpp]
